masteravinashdubey/2020-Model_Based_Cycle_Robot_PID/GROUP photo.JPG

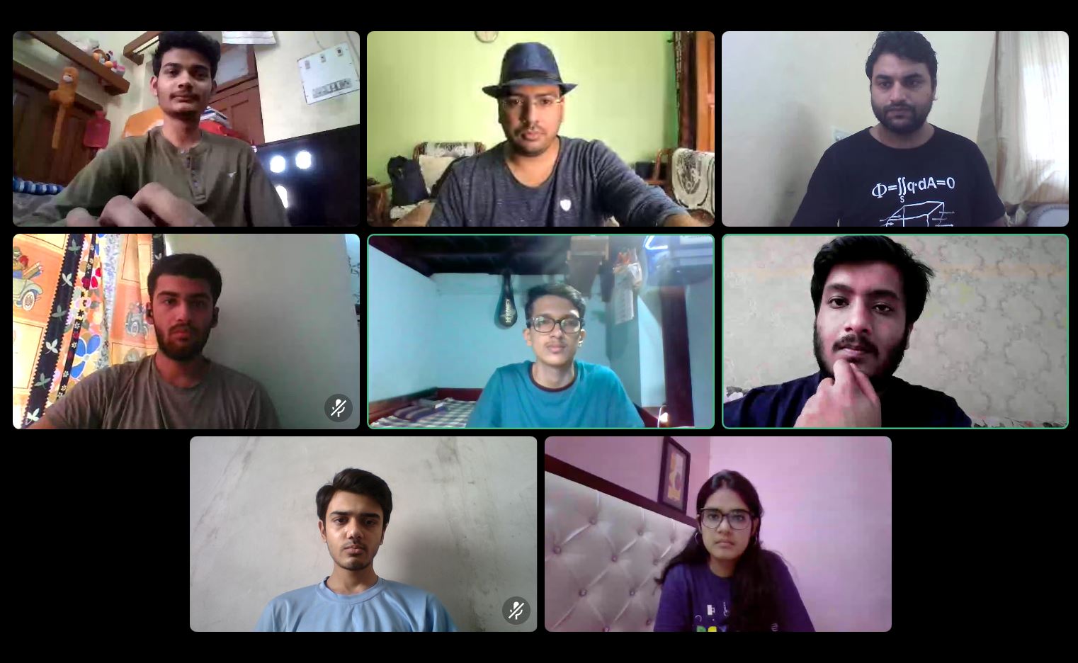
GROUP photo.JPG
