masteravinashdubey/2020-Model_Based_Cycle_Robot_PID/README.md

here we are putting week wise files in week wise folders
The video link for the project is given here : <a href="https://www.youtube.com/watch?v=8YgCfRb5XRs&list=PLK0jpMYIBd6B1-mDQZwADi5OlnOiK6k9m&index=17">PID Based Cycle Robot</a>
