masteravinashdubey/2020-Model_Based_Cycle_Robot_PID/Final submissions/Readme.md

In this folder the file "cycle_bot_E-yantra_team17B" is a research paper on self-balencing cycle bot using PID controler.

2nd file named "Final_report_cyclebot.pdf" is whole conclusive report about construcion, testings and conclusion of this cycle bot during Internship.
