masteravinashdubey/2020-Model_Based_Cycle_Robot_PID/week 5-6/developing code/README.md

currently working file is 'take_2'
all other files are under construction 

in order to run files on your machine all zip librery files in librery folder must be installed on your machine
to do so follow the steps

1)download the librery folder 

2)go to arduino skectch

3)select in menubar sketch ==> include librery ==> add .ZIP librery

4)nevigate to the downloaded librery folder through in the opened window and selact available zip files there 

5)press select button

doing this will add all librery to your arduino set up and you are ready to go
