masteravinashdubey/2020-Model_Based_Cycle_Robot_PID/week 3/experiment 1/solution_Design.pdf

# ROBOT DESIGN AND ITS IMPLEMENTATION

June 1, 2020

Task 1:

Choose the design of the robot and justify “Where and Why” the component is placed there.

Task 2:

Implement the robot in v-rep with all actual parameters to see its behaviour and the problems that we will face in future while working on physical implementation.

Solution

The bot which we choose is CYCLE BOT, then, we choose all the components to control, stabilize and maneuver the cycle bot. The cycle bot is maneuver and controlled manually by a remote that will be explained in a better way with the experiments in the next experiments.

Now, the task is what are the components needed and where to place it.

COMPONENTS NEEDED:

1. Servo Motor – It is used to give the left – right motion to the cycle bot.
2. Battery – for power supply.
3. 2 Xbee’s – one for transmitting wireless data and one for receiving.
4. Joystick – To control the parameters speed and left right motion.
5. Arduino mega – as a controller to control all the components according to the sensor input.
6. Gyroscope – for the angle of the cycle bot.
7. Motor driver – To control the speed of the motors according to the PWM signal by controller.
8. 2 DC motors :
- one is for the back wheel motor for controlling the speed of the cycle bot and to forward and back movement. Torque of the motor will be high because it has to give movement to whole cycle bot.
- second is for the reaction wheel to stabilize the cycle bot and RPM of this motor will be high because of the instantaneous change of recovery angle and direction and motor has to react quickly accordingly.

Now, it’s time for where and why we placed this component to that place.

WHERE AND WHY?

This the main design of the cycle bot in v-rep simulator.

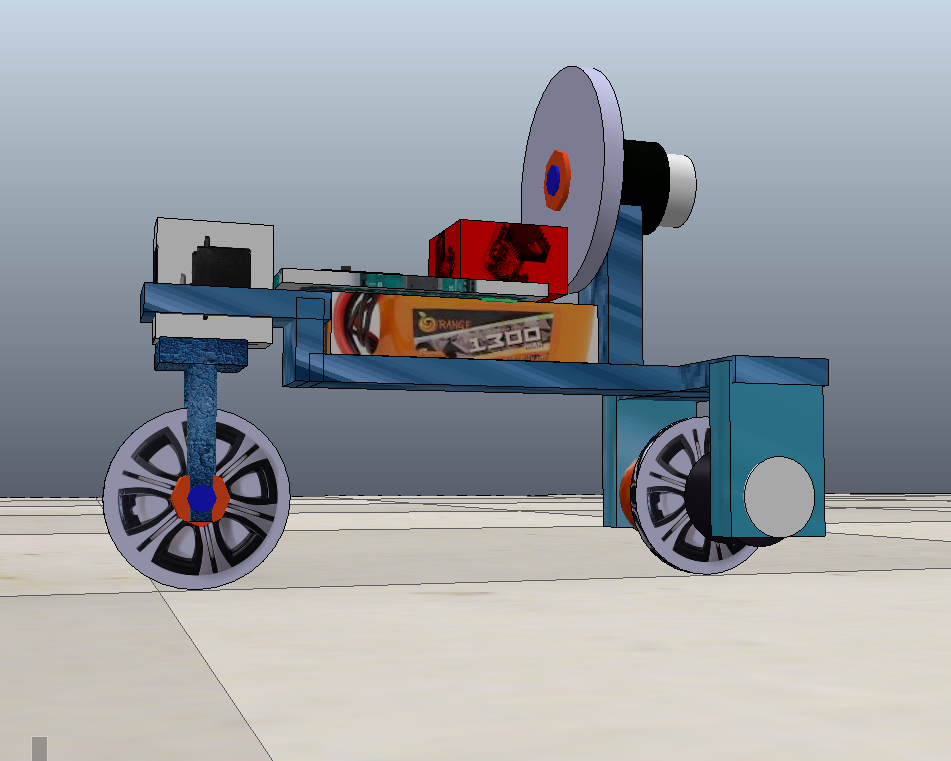
[picture p13: figure]

Servo motor : It has to control the handle of the bot. So, we placed it at the top of the handle fixed with the body of the base as shown in the figure given below. If we place servo motor anywhere else then, we use extra connecting things in between to control the handle this will reduce the torque of the servo motor and also apply some constraints to restrain its motion properly.

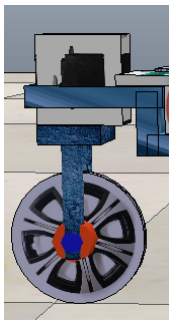
[picture p14: figure]

BACK WHEEL DC MOTOR: Now, to control the speed and forward/backward movement of the cycle bot we directly attached the dc motor with the back wheel. We can connect it through gears and belt drives but we don’t do that because we want to make it as our physical cycle bot and at this time the resources for these things(like gear and belts) is not available, so we have to make it through limited resource. But, by this approach it makes our system more towards unstability, So to counter this this we added counter weight to the other side of the motor. Counter weight is not attached to the back wheel motor spindle.Motor and counter weight is of the same weight.

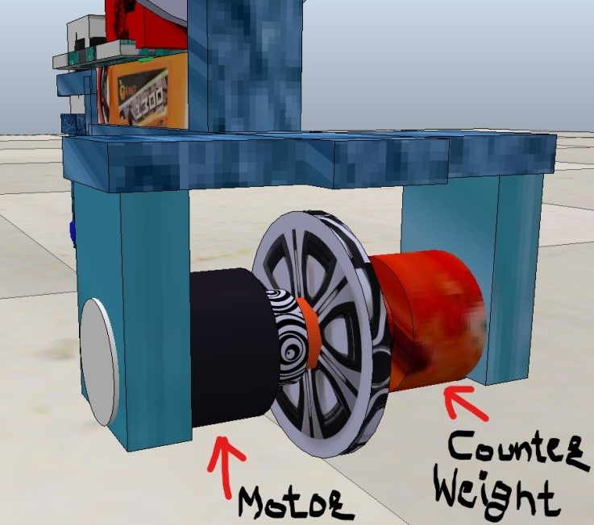
[picture p15: figure]

BATTERY, XBEE, MOTOR DRIVER AND ARDUINO MEGA : If you take a look because of the motor and counter weight the system weights shifts towards back which make it unstable. So the placement of battery , xbee, motor driver and mega plays crucial role to balance the weight. So we places all the other components at other side to make it stable(weights of the things are kept in mind while placing this components) as shown in figure. If we add one component to other side it make it unstable.

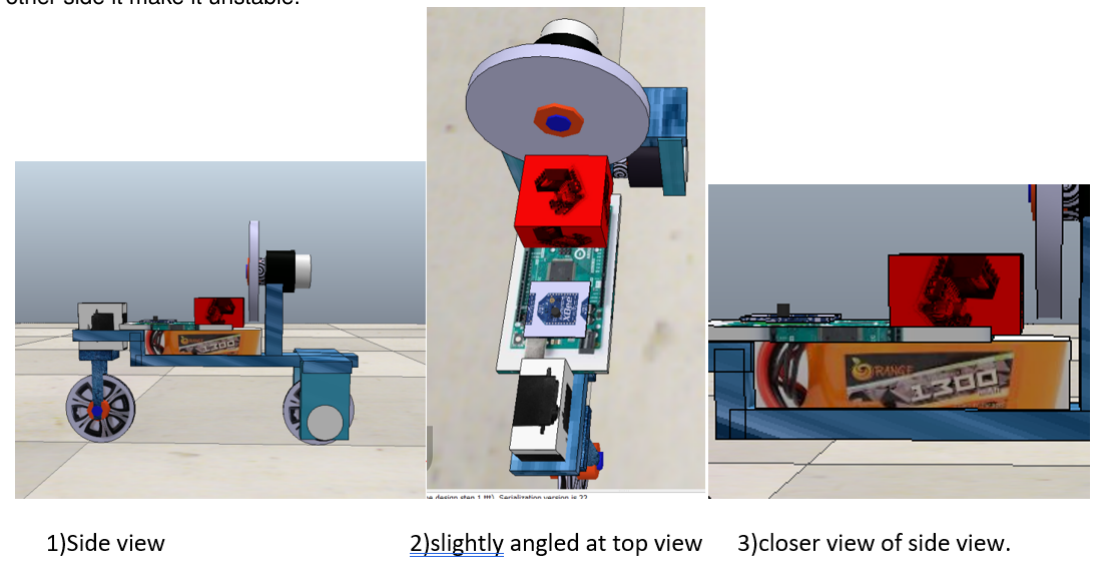
[picture p16: figure]

PLACEMENT OF REACTION WHEEL AND ITS POLE: Place the pole to which reaction wheel is attached as close to centre of mass or at the center of mass if possible because of the components placement and other factors it is not completely possible but there are some cases at which it is possible. So that, the reaction wheel should appropriate force to stabilize the whole cycle body because this point represents the whole mass of the body. And by applying appropriate force it can be easily stabilize.

IMU-GYROSCOPE : You can place it near the reaction wheel pole(or centre of mass) and make sure to get the angle of the base body of the cycle and placed upon it also because it doesn’t depend upon any other components placement and all the components are not permanently fixed. So, when the vibrations occur it displaces from its position and orientation then, in this case it will generate a very little error and then, it effects the stability of the system.
