masteravinashdubey/2020-Model_Based_Cycle_Robot_PID/week 3/experiment 5/problem statement.pdf

# COMMUNICATION PROTOCOL AND REMOTE DESIGN

June 1, 2020

Experiment:To control the speed of the DC motor wirelessly by varying potentiometer at other end.

The main aim of the experiment is to know about the various communication protocols(serial communication and wireless communication) it works upon.

Details of the experiment :-

The experiment consists of two parts-

1. Input part: in which we vary input signal via potentiometer and use Xbee module and development board to send data.
2. Output part: In this section we have to receive data using Xbee module and development board and react accordingly to control the speed of the motor via motor driver.
