masteravinashdubey/2020-Model_Based_Cycle_Robot_PID/week 4/experiment 2/problem statement/Problem statement.pdf

# Problem statement (experiment 2)

In most of application we need to discretize continuous signals while interacting with real world. For measuring some real world quantity with a microcontroller we need to sample it with some required time period to discretise it for processing. Now in most of process we cannot assume that microcontroller general program will be able to sample it at same time interval as program execution flow may depend on conditional statements. So the solution for this kind of application is to use timer interrupt instead of sample the quantity within the normal execution of program with hope of same time interval within next sample.
In this experiment you have to do following tasks:
1. Read the data sheet of timer/counter portion and list out registers to be modified.
2. Justify the reason for which values to be written in which register to blink led at every 500 ms using timer interrupt.
3. Complete the given skeleton code to perform experiment
4. Test it on hardware.
