masteravinashdubey/2020-Model_Based_Cycle_Robot_PID/week 5-6/1 Effects of Proportional Controller.pdf

# Effects of Proportional Controller

The controller sees the error as input. If the error is small, the controller should suggest a small action, a nudge, to the actuator to get the plant back on track and reduce the error to 0. If the error is large, that means that the actual value has drifted far away from the desired value. The controller needs to suggest a large action to the actuator to bring the plant in line with the desired value. Such a strategy means the controller action should be proportional to the error, i.e. Paction. The proportional gain, KP , can also be regarded as the sensitivity of the controller, how great an action it will suggest for a given deviation of actual from desired. If KP is high, the controller will take a large action for a small deviation of actual from desired. The controller is very sensitive. If KP is small, the reaction of the controller to a deviation of actual from desired is gentle.
Proportional action is based upon the current value of error.
The proportional controller produces an output, which is proportional to error signal.

U(t) ∝ e(t)

U(t) = Kp ∗ e(t)

Applying laplace transform on both the sides

U(s) = Kp ∗ E(s)

U(s)
E(s)

= Kp

Therefore, the transfer function of the proportional controller is Kp. Where,
U(s) is the Laplace transform of the actuating signal u(t)
E(s) is the Laplace transform of the error signal e(t)
Kp is the proportionality constant
The block diagram of the unity negative feedback closed loop control system along with the proportional controller is shown in the following figure.

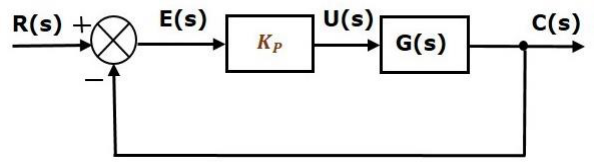
[picture p25: figure]
