masteravinashdubey/2020-Model_Based_Cycle_Robot_PID/week 5-6/5 Strategy for Navigation Via Remote Control.pdf

# Strategy for Navigation Via Remote Control

Cycle Bot will balance at its own by the use of reaction wheel. So, we have control only the Navigation process i.e divided into 4 categories given below:-

1. Forward Motion
2. Reverse/backward Motion
3. Left Motion
4. Right Motion

All this motion will be controlled by joystick wireless and manually as per the rider need, he/she should control the motions of cycle bot.
When the joystick is in its home position as shown in the figure below, the cycle bot will also remain at its home position i.e no motion in forward, backward, left or right. It just balances itself.
The joystick has two axis, X- axis is used to control the left right motion and Y-axis is used to control the forward backward and speed of the cycle bot.
HOME POSITION OF THE JOYSTICK

FORWARD AND BACKWARD MOTION WITH SPEED CONTROL
When you pushes the joystick forward in y- axis the cycle bot go in forward direction with the speed depending upon the throttle value. When you push joystick forward at its maximum position that means at its maximum throttle value and the bot at its maximum speed. At the home position it attain its minimum speed with no direction. Same for the reverse motion but you have to push joystick in opposite direction. The speed will vary with the throttling value.

LEFT AND RIGHT MOTION
For the left motion you have to push left from home position of joystick and for right motion you have to push the joystick in right direction. The angle will not vary with the change in throttling value. The angles are fixed with some discrete values and it will follow and rotate only at that angles.

For left rotation of the handle to give bot left motion. At extreme position, the handle will rotate and set at 60 degree and for any other left throttle value it will rotate and set the handle at 30 degree.
For Right rotation of the handle to give bot right motion.
At extreme position, the handle will rotate and set at 60 degree and for any other right throttle value it will rotate and set the handle at 30 degree.
Image below explain the strategy for navigation via remote control by the use of joystick.

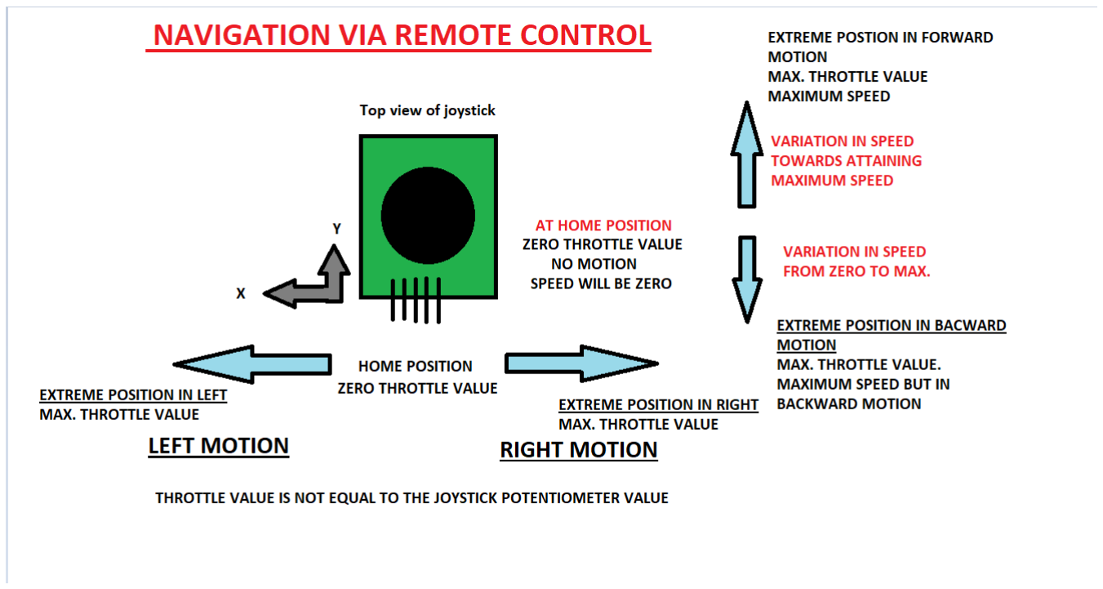
[picture p31: figure]
