masteravinashdubey/2020-Model_Based_Cycle_Robot_PID/week 4/experiment 1/solution/3 Theory Discrete time domain transfer function.pdf

# Discrete time domain transfer function

We know that in continuous time system we represents the systems with in terms of impulse response of system in Laplace domain we called this mathematical equation as transfer function of system. This s- domain represent of system opens doors for wide range of stability and system performance analysis easily by graphical method of poles and zeroes plots. But if we want to analyse system in simulations or to design controllers. While digital analysis some other factors like time discretisation, non-linearity, quantisation error etc. we must have to deal with while analysing system so s-domain analysis beings in accurate. The problem is solved by introducing a new analogy especially for discrete signals and systems called Z-domain analysis. Z- Domain analysis is as useful for discrete system as s-domain for continuous system. Z-domain:
Actually all natural systems are continuous time system but to deal with it we need to analyse it in the sense on discrete time system. We are having main two way to convert continuous time domain system in to discrete time z-domain.
1. Mathematical conversion for time domain to z-domain.

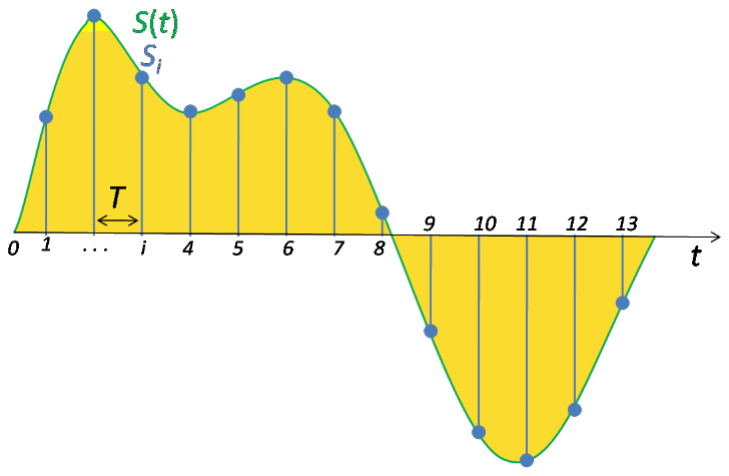
[picture p32: figure]

Figure 1:

First of all sampling our system with the sampling period we gets our tome domain equation of system X(t) converted to discrete time system X[n], where n is nth sample from initial time and X[n] gives value at that time. Now making this impulse response as transfer function using equation below:

X(z) = Z{x[n]} =

X∞

n=−∞

x[n] ∗ z

−n
(1)

Alternatively, in cases where X[n] is defined only for n>0, the single-sided or unilateral Z-transform is defined as

X(z) = Z{x[n]} =

X∞

n=0

x[n] ∗ z

−n
(2)

Here X(z) is our transfer function of system if X[n] is sampled signal of impulse response of system.

2. Deriving system transfer function first and then converting it to z-domain using quick conversion.
Suppose we are having S-domain transfer function X(s) and we want convert it to Z domain transfer function X(z) by sampling system with Ts sampling period. For doing this we need to correlate every point ‘s’ of s-domain to its appropriate location ‘z’ in to the z-domain. Relation between them is defined as below.

Z = e

S∗TS | (3)

where S = σ + j ∗ ω

T herefore, Z = e

σ∗TS ∗ e

j∗ω∗TS | (4)

Using this definition we can convert s domain transfer function in to the z domain transfer function. In general we uses the quick conversion table to do this conversion without efforting much calculation you can found this table here... https://lpsa.swarthmore.edu/LaplaceZTable/LaplaceZFuncTable.html
Now in equation 4 we can say that, the amplitude of vector z will be

| Z |= e

T σ | (5)

And angle with real axis will be..

∠Z = ωT

So if we compare z plane with s plane we can say that if increase imaginary part of location s in s plane our corresponding location of z in z plane will move in circular path or you can say that the angle of vector z will increase. Our imaginary axis in s-plane will be σ = 0 corresponding locations in z plane it will make a circle with the amplitude of 1 and cantered at the origin as shown in diagram 2. In s plane our origin will be s=0,so using equation 3 we can say that point z= +1 will correspond to that.

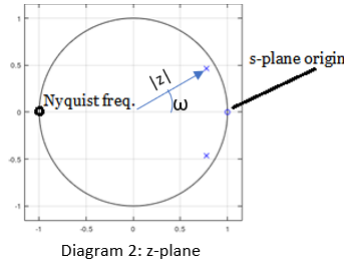
[picture p33: figure]

Here one question arises is that in s-plane imaginary axis tenced o infinity but in the z-plane it just gets limited to a half circular arc. But actually when we converts a continuous system to discrete system one problem occurs because of sampling frequency is called aliasing, as the solution of that we defines the nyquist frequency up to which only our system can respond accurately. We have seen that the nyquist frequency is half of the sampling frequency. And inquest frequency is a frequency up to which we bounds our system to avoid aliasing. So in z plane arc starting from z=1 to z=-1 corresponds to 0 to nyquist frequency on imaginary axis in s-plane as shown in diagram 3 by yellow line. Here we can say that how much the sampling frequency increases, the nyquist frequency also increases and the arc in z plane will contain more range of frequency or in other words our z- plane area starts shrinking and plotted poles come more near to each other as shown in figure 3.

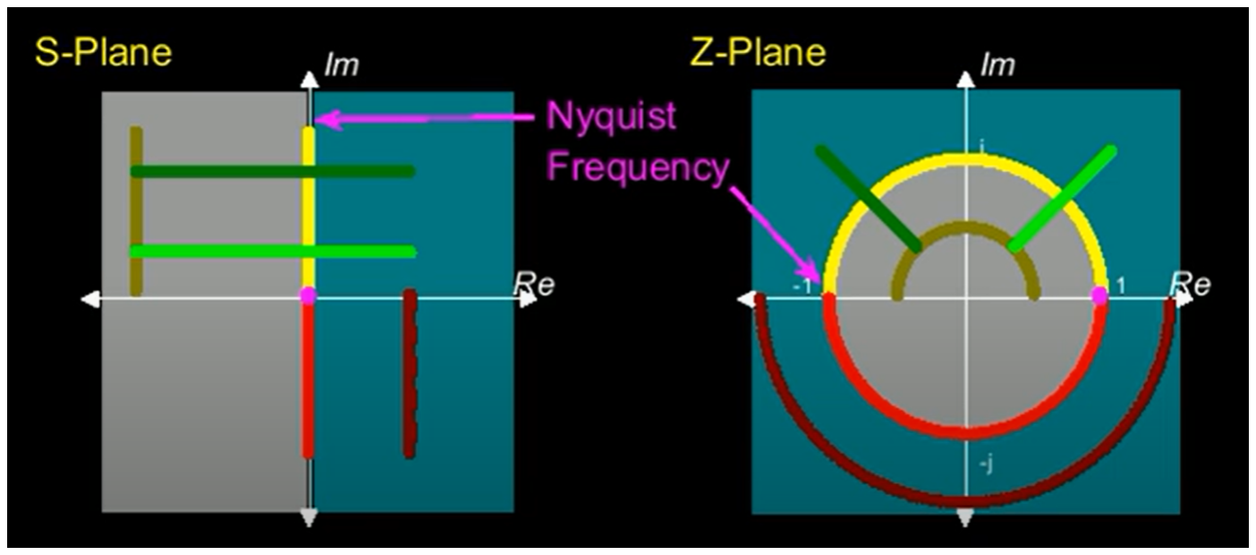
[picture p34: figure]

Figure 2: In this diagram same colour points are corresponding points in both planes.

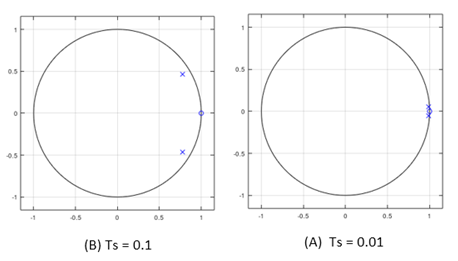
[picture p35: figure]

Figure 3: poles and zeros of same system with diffrent sampling time.

3. Comparing stability criteria:
In s plane if at least one pole lies in the right half plane than the system beings unstable. So, from equation (5),
