masteravinashdubey/2020-Model_Based_Cycle_Robot_PID/week 2/experiment 1/solution/2 theory_stability.pdf

# Solution 1 (poles, zeros and stability)

May 26, 2020

In any system the position of pole and zeros gives us idea about its stability and performance. Actually the idea about poles is enough to state about stability.

Zeros = The value of ‘s’ for which the transfer function becomes zero

Poles = The value of ‘s’ for which the transfer function becomes infinity

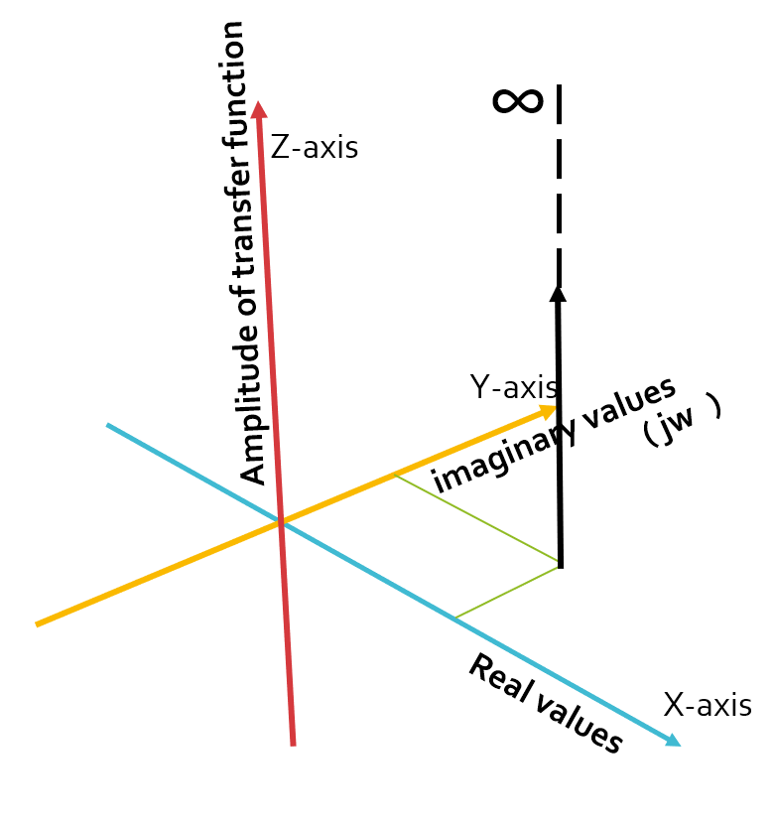
[picture p36: figure]

Figure 1:

If we explain the phenomenon graphically, there is a 3d space in which x- axis represents the real part in the value of ‘s’ in transfer function, y axis represents the imaginary part in the value of ‘s’ in transfer function and z axis contains value of transfer function for corresponding value of s. if the value of transfer function approaches infinity for some value of ‘s’ that value of s is said to be pole of the system.

Value Transfer function can only approaches infinity if its denominator becomes zero so equating denominator with the zero and solving it gives us the location of pole on x-y plane which also called as s-plane.

As for analysing system just location of pole is important, in general we just plots top view of the 3d space (s-plane) as shown in fig.2

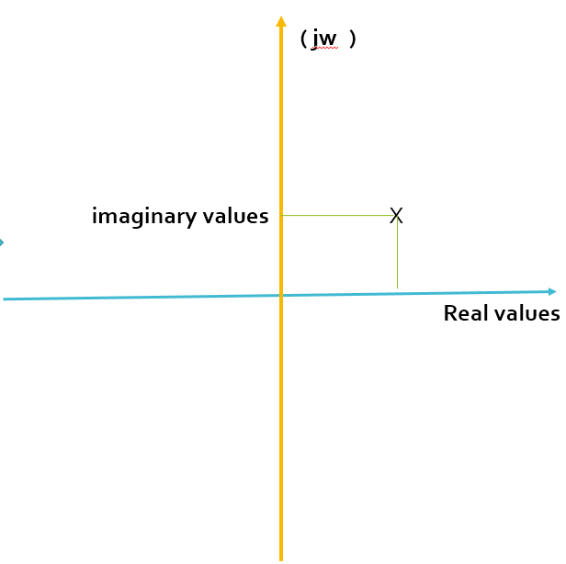
[picture p37: figure]

Now if poles lies on the real axis, it impulse response will be a decaying or increasing exponential curve and its decaying/increasing rate depends on its mod value. As if it’s negative real axis then we get exponentially decaying impulse response. And if it’s on positive real axis then we will get exponentially increasing with the factor of its value.

If our pole lies on imaginary axis we gets sine wave as the response and if the pole location is having some complex value the impulse response of the second order system will be a sine wave with exponentially increasing or decreasing amplitude as shown in fig 3 and 4

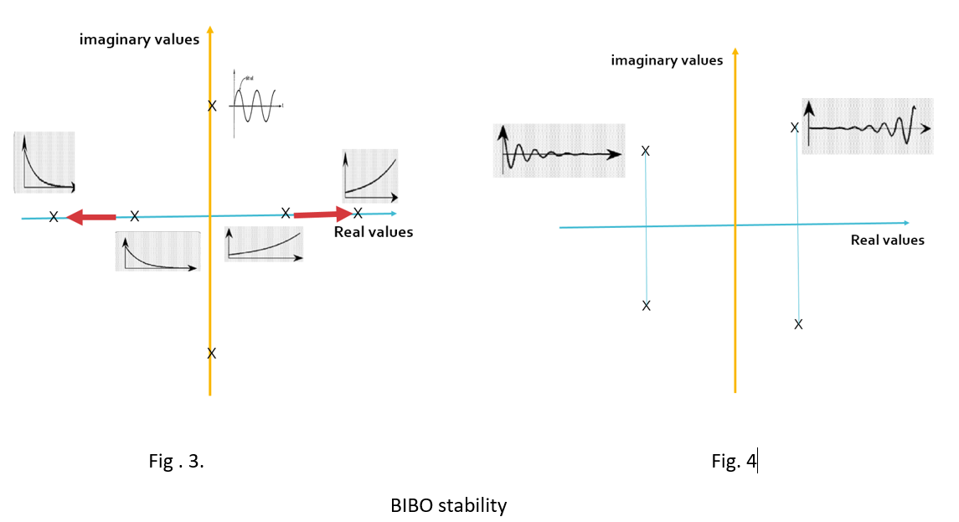
[picture p38: figure]

Uptill now we have seen the impulse response of an second order system according to poles position. But in case of a real system we can apply any kind of input signal, therefor the stability defines as below.

- If you apply bounded input and you will get bounded output then the system will be stable.

- If you apply bounded input and you will get unbounded output then the system will be unstable.

So as a conclusion we can say that if our poles lies in the left half of the s-plane system will be always stable but if any of the poles lies in the right half of the plane the system will be unstable and if our poles lies on the imaginary axis the system is said to be marginally stable as shown in fig.5.

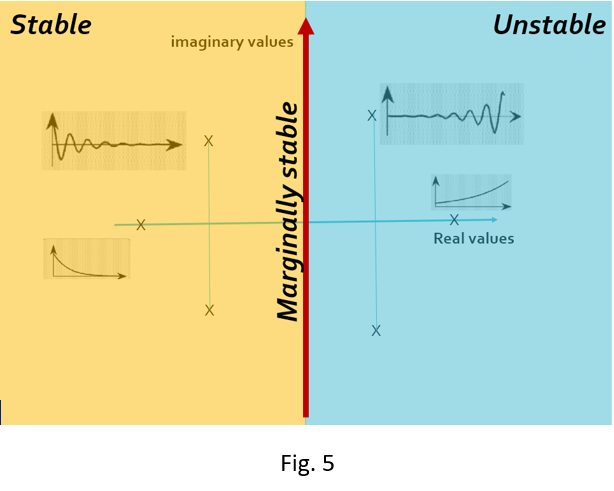
[picture p39: figure]
