masteravinashdubey/2020-Model_Based_Cycle_Robot_PID/derived transfer function.pdf

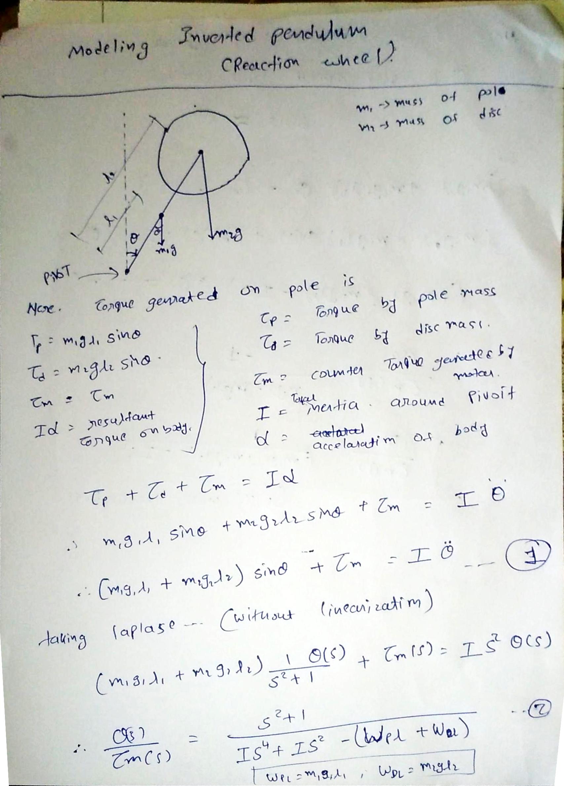
[picture p40: page 1]
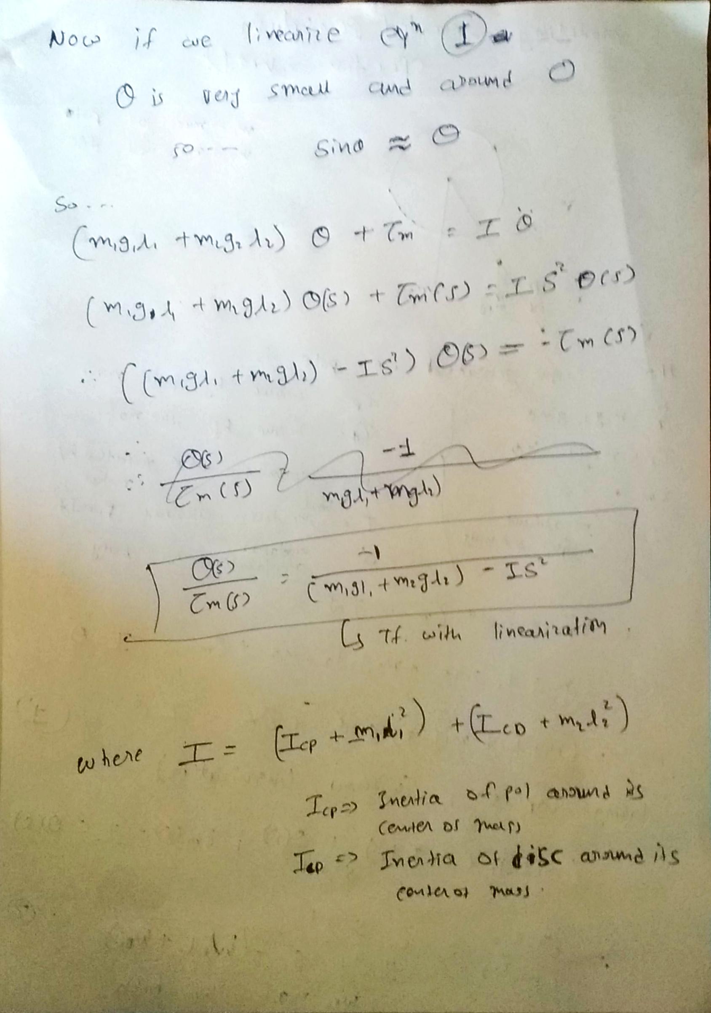
[picture p41: page 2]
