masteravinashdubey/2020-Model_Based_Cycle_Robot_PID/week 5-6/3 Why not Derivative or Integral Controller alone.pdf

# Why not Derivative or Integral Controller alone?

Now, from the previous documents of P-I-D, we know how Proportional, Integral and Derivative controller works and the problems that these controller solves to work as a proper PID controller. But Is it possible to use Derivative and Integral controller alone? Lets see. . . INTEGRAL ALONE :-
Yes, it is possible to use integral controller alone. It does not exhibit steady state error, but is relatively slow responding. It really makes the system very slow and if try to further increase the integral gain(ki) it will create oscillation which is undesirable. That’s why we don’t use Integral alone but use proportional with it.
PI controller- This will solves the problem of both the controllers i.e steady-state error in case of proportional controller and slow response in case of Integral controller. But it will not make system very fast but it will make system relatively faster than the Integral controller.
This controller is not used where very fast response is required.
DERIVATIVE ALONE :-
No, it is not possible to make derivative controller alone, just think about it, derivative only works where there is change in the error but if some constant error occurs it will make derivative control signal zero. And our system doesn’t behave and stop responding. That’t why we PD controller (Proportional plus Derivative).
PD controller- It is effective for systems having large number of time constants. It results in a more rapid response and less offset than is possible by pure proportional control. But one must be careful while using derivative action in control of very fast processes, or if the measurement is noisy.
This controller is very sensitive to the noises, so the kd gain must be very precise in that case. In many examples in real and virtual controllers we need the controller which is smooth, robust and optimal. Depending on the environment, physical constraints and requirement we have to choose our controller which works perfectly for our system.
