masteravinashdubey/2020-Model_Based_Cycle_Robot_PID/week 5-6/4 Implementing_pid_in _arduino_And_tuning_the_parameters.pdf

# Implementing PID in Arduino and Tuning the

Parameters.

Implementing PID in Arduino.
In cycle bot, using PID controller we will control the PWM signal for the speed of reaction wheel to balance the bot. In PID controller it has one INPUT and one OUTPUT. So, the output of the controller will be PWM signal and in input to the controller is error. Now, the where is this error come from.
Error is the difference between the angle measured by the sensors and the desired angle. We used this algorithm to implement PID in arduino given below :-

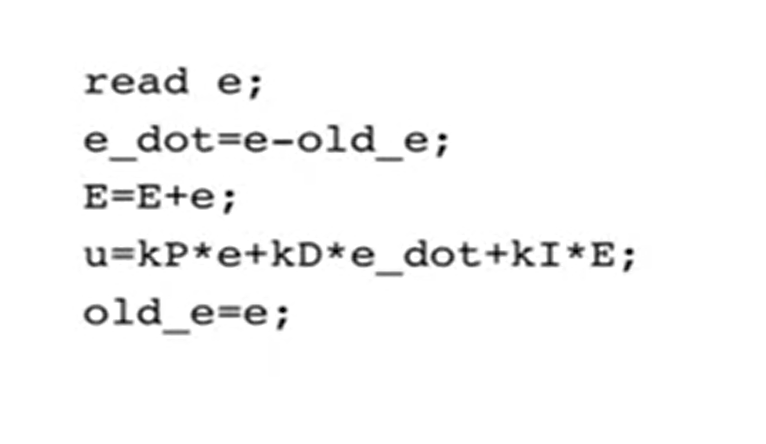
[picture p42: figure]

Figure 1: Reference of image:- control of mobile robots, GRITS, coursera

where,

e = error,

olde = previouserror,

E = integratederror,

edot = derivativeerror,

Kp = proportionalgain,

Kd = derivativegain,

Ki = integralgain

u = PWMsignal.

One thing in that algo is that we are not included sampling time( deltat) neither on integral part nor on derivative part because it a constant value and can be compensated by choosing the correct gain value for both integral and derivative regulator.

Tuning the Parameters.
There are various methods available you can choose any of them, the condition is your controller should be optimal, stable and robust. We are using two methods to tune the parameters of PID gains i.e Heuristic A Method and Zeigler-Nichols Method . You can choose any of the them which give accurate results that you want.
Heuristic A Method
The method consists of the following steps:
1. Set all gains to zero.
2. Increase the Kp until the response to a disturbance is steady oscillation.
3. Increase the Td until the oscillations stop (i.e. it’s critically damped).
4. Repeat steps 2 and 3 until increasing the Td does not stop the oscillations.
5. Set Kp and Td to the last stable values.
6. Increase Ti gain until the convergence to the set point occurs with or without overshoot at an acceptable rate.

Zeigler-Nichols Method
The basic tuning steps are:
1. Set all gains to zero.
2. Increase the Kp until the response to a disturbance is steady oscillation. This is called the ‘ultimate’ gain Ku.
3. Measure the ‘ultimate’ oscillation period Tu at this steady state.

Ku and Tu can then be used to calculate values for Kp, Ti and Td, depending on the type of control algorithm implemented, according to the table below.
TABLE TO CALCULATE THE PID GAIN
Control Type | Kp | Ti | Td
P | 0.5Ku | – | –
PI | 0.45Ku | Tu/1.2 | –
PD | 0.8Ku | – | Tu/8
Classic PID | 0.6Ku | Tu/2 | Tu/8
Pessen Integral Rule | 0.7Ku | Tu/2.5 | 3Tu/20
Some overshoot | 0.33Ku | Tu/2 | Tu/3
No overshoot | 0.2Ku | Tu/2 | Tu/3

Table 1: Reference (https://arduinoplusplus.wordpress.com/2017/06/21/pid-control-experiment-tuning-the-controller/)

Ku and Tu were determined in Step 2 in the previous method . Calculating it all out in a table above provides all the coefficients for the different test settings.
