masteravinashdubey/2020-Model_Based_Cycle_Robot_PID/week 3/experiment 3/solution/data fusion solution.pdf

# Solution of experiment 4

May 31, 2020

Requirement of a filter and data fusion:

Here we are using gyro sensor to estimate angle or inclination around x axis but we are doing this job by integrating gyro data as data from gyro is angular velocity. Because of integration the small error in beginning beings additive and it tenses to drift real values of result. Other problem with angle derivation from gyro is it can work accurately only for slow moving signal.

So as a solution we can use accelerometer as a solution right? The answer is no, because accelerometer derives acting force on all three axis and its very sensitive to detect any disturbance and also reacts so much quickly with any changes so derived angle from it gets affected by any external disturbance like vibrations of actuators, reaction forces, change in wind flow etc. but accelerometer works well for fast moving signals.

On MPU 6050 we are having both the sensor at a place so why not to merge the data of both to prevent gyro to drift away and make system work for both fast and slow moving signal noiselessly.

But the question is how to merge both the data for same physical parameter (here the rotation angle around X axis). For that there are so many filters to merge data like Kalman filter, complementary filter etc.

If we compare kalman filter and complimentary filter, the Kalman filter is having more accurate performance then complementary filter as it works on predict and update algorithm but it requires more computation power than complementary filter. Whether complementary filter is having very less computation power and easy to implement. Here we are just to demonstrate how to fuse data of 2 sensors so we are going to use complementary filter.

Complementary filter:

Idea behind complementary filter is to take slow moving signals from accelerometer and fast moving signals from a gyroscope and combine them. Accelerometer gives a good indicator of orientation in static conditions. Gyroscope gives a good indicator of tilt in dynamic conditions. So the idea is to pass the accelerometer signals through a low-pass filter and the gyroscope signals through a high-pass filter and combine them to give the final rate. The key-point here is that the frequency response of the low-pass and high-pass filters add up to 1 at all frequencies. This means that at any given time the complete signal is subject to either low pass or high pass.

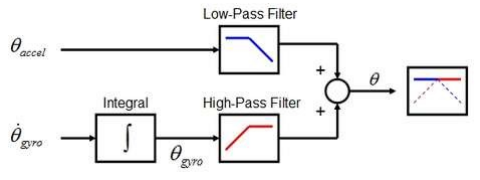
[picture p61: figure]

Equation for low-pass filter:

y[n] = (1−alpha)∗x[n]+alpha∗y[n−1] //use this for angles obtained from accelerometers

x[n] is the pitch/roll/yaw that you get from the accelerometer

y[n] is the filtered final pitch/roll/yaw which you must feed into the next phase of your program

Equation for high-pass filter:

y[n] = (1−alpha)∗y[n−1]+(1−alpha)∗(x[n]−x[n−1]) //use this for angles obtained from gyroscopes

x[n] is the pitch/roll/yaw that you get from the gyroscope

y[n] is the filtered final pitch/roll/yaw which you must feed into the next phase of your program

n is the current sample indicator.

alpha is related to time-constant. it defines the boundary where the accelerometer readings stop and the gyroscope readings take over and vice-versa. It controls how much you want the output to depend on the current value or a new value that arrives. Both the alpha’s have to be the same. alpha is usually > 0.5 using the definitions above.

Alpha:

alpha =

tau
tau + dt
where tau is the desired time constant (how fast you want the readings to respond) and dt = 1/fs where fs is your sampling frequency. This equation is derived from filter/control theory. Will put a link to this as soon as I get it.

A quick way of implementing a complementary filter:

angle = (1 − alpha) ∗ (angle + gyro ∗ dt) + (alpha) ∗ (acc)

First reading is the angle as obtained from gyroscope integration. Second reading is the one from accelerometer.

In the case that gyro = 0, angle will converge to that given by accelerometer.

If alpha is really small the output angle will not believe the reading from the accelerometer so readily and will believe the gyroscope as and when it happens.
