masteravinashdubey/2020-Model_Based_Cycle_Robot_PID/week 5-6/testing graphs/Kp = -130, Ki = -40, Kd = -2.1.JPG

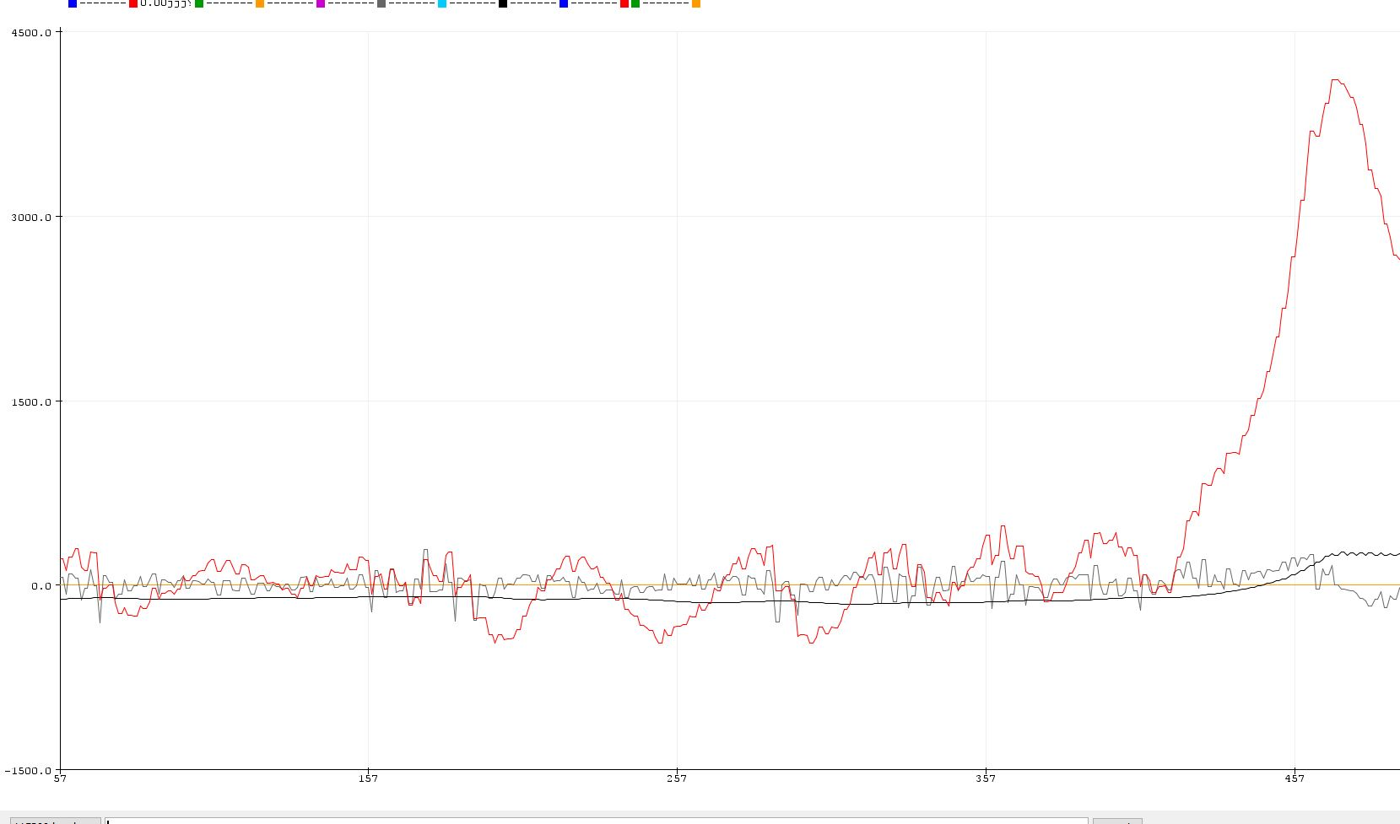
week 5-6/testing graphs/Kp = -130, Ki = -40, Kd = -2.1.JPG
