masteravinashdubey/2020-Model_Based_Cycle_Robot_PID/week 5-6/testing graphs/Kp = -170, Ki = 0, Kd = -2.1.JPG

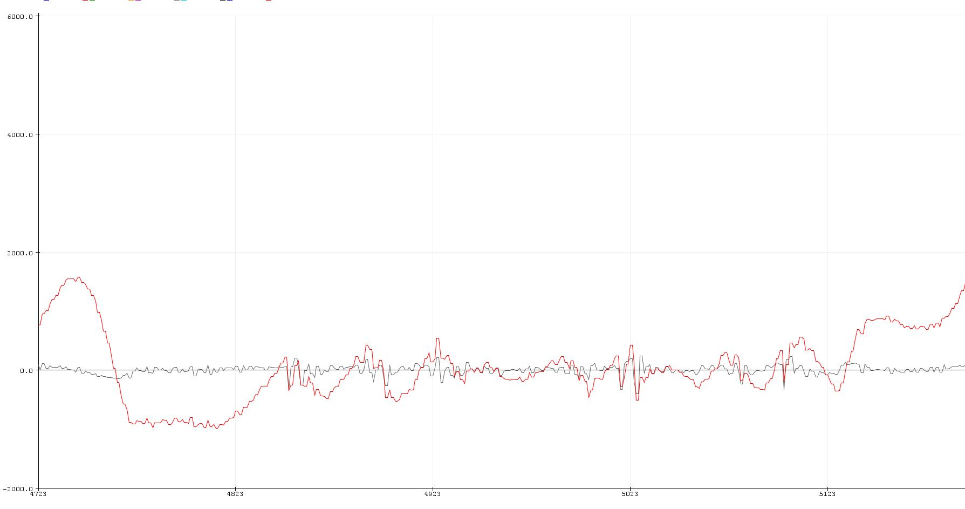
week 5-6/testing graphs/Kp = -170, Ki = 0, Kd = -2.1.JPG
