masteravinashdubey/2020-Model_Based_Cycle_Robot_PID/(commit log)

2020-05-17 reaction wheel simulation vrep
    The files are working perfectly but Ki and Kd is behaving something strange... and also required different signs then Kp
2020-05-18 corrected errors in data fusion
    in previous code the integration of gyro data we were doing was by using previous data of gyro it self but in this i have changed integration by' inclinationgyro = inclination2 + angularVariationX*dt '
    second change is in previous code direction of accel angle and gyro angle was different so i have inverted angle calculated by accelerometer.
2020-05-18 Spring mass damper system in scilab
2020-06-10 code of getting angle from mpu6050
    In this code, angle is obtained by using both gyroscope and accelerometer combining both the values by complimentary filter.
2020-06-11 genagating first header files
    3 header giles are there
    remote
    motor controle
    mpu 6050
2020-06-11 pics from this ppt is used in Pid documentation
2020-06-11 code with micros done
    all header files are tested still PID tunning is remaining
2020-06-11 This file will be modified using interrupts
    still under working
2020-06-16 tuned ofsets in sensors
    currently working on this version
2020-06-17 tunned the complimenatry filter gain
2020-06-17 using servotimer2 librery to avoid collision of timmers
    all ISR vectors are perfect
    registr configuration is also perfect
    ISR of timer1 is not conflicting with ISR of Servo (solved issue)
    unsolved issues :x:
    the servo is behaving wiard while running ISR B with datafusion call
    all ISR gets crashed while i uncomments ISR C because of interaction with MPU 6050(nay be because it uses ISR too)
    [motor_run.h, mpu_header.h, remote_x.h]
2020-06-18 servotimer2 librery zip file to be included
    the librery is to be included to arduino environment to include it in program code
2020-06-18 issue of nested interrupt for reading IMU has been solved
    the problem was that for using globle buffer for I2C communication triggers an interrupt but as interrupt gets deisable while entring in ISR of one interrupt the data fatching process couldn't be done.
    i have again enabled globle interrupt from after entring ISR to allow nested interrupt to work and hance issue has solved
    [mpu_header.h]
2020-06-21 mat lab files for auto pid tunning
2020-06-22 well comented arduino code
    code is organized and well commented
2020-06-23 updated file using interrupt
    there was an error that TCCRB register was by mistake written as TCCRA so its corrected
    in this file i have tested the concept of 1 timer 3 compare match interrup functionality -> its working fine
    i have also satteled sampling time to 10 ms and cmr C to 4ms / cmr B to 7 ms and cmr A to 10 ms (from where timer will overflow)
    also all thigs dose well commented
    [motor_run.h, mpu_header.h, remote_x.h, testing_print.h]
2020-06-23 comments spell mistake corrected
    led also introduced
    [mpu_header.h, remote_x.h, testing_print.h]
2020-06-23 resolved the all code errors
    the code is to ensure 10ms uniform sampling using timer and its fully functional now
    [mpu_header.h]
2020-06-30 analysis graph folder added
    these photos are for 2 chain reaction wheel/ISR working code
2020-07-09 sample rate changed
2020-07-20 combined LQR and PID controler
    in this code we can chose which controler(PID or LQR) we need to implement by just commenting and uncommenting 2 lines as defined in code main file
